TheTesla/ATXMega32a4u-USB-Breakout/README.md

ATXMega32a4u-USB-Breakout
=========================

Breakoutboard for ATXMega32a4u to ATXMega128a4u with micro-USB

Creator: http://entroserv.de

Support: support@entroserv.de (german and english)

# Quickstart

power up: connect 3.3 V to pin3 and GND to pin2 -> yellow led is illuminated

programming: connect atmel jtagice3 to the pdi header on top side of the board
