TheTesla/ATXMega32a4u-USB-Breakout/Hinweise/Hinweise.tex

%% Basierend auf einer TeXnicCenter-Vorlage von Mark Müller
%%%%%%%%%%%%%%%%%%%%%%%%%%%%%%%%%%%%%%%%%%%%%%%%%%%%%%%%%%%%%%%%%%%%%%%

% Wählen Sie die Optionen aus, indem Sie % vor der Option entfernen  
% Dokumentation des KOMA-Script-Packets: scrguide

%%%%%%%%%%%%%%%%%%%%%%%%%%%%%%%%%%%%%%%%%%%%%%%%%%%%%%%%%%%%%%%%%%%%%%%
%% Optionen zum Layout des Artikels                                  %%
%%%%%%%%%%%%%%%%%%%%%%%%%%%%%%%%%%%%%%%%%%%%%%%%%%%%%%%%%%%%%%%%%%%%%%%
\documentclass[%
a4paper
%a5paper,							% alle weiteren Papierformat einstellbar
%landscape,						% Querformat
%10pt,								% Schriftgröße (12pt, 11pt (Standard))
%BCOR1cm,							% Bindekorrektur, bspw. 1 cm
%DIVcalc,							% führt die Satzspiegelberechnung neu aus
%											  s. scrguide 2.4
%twoside,							% Doppelseiten
%twocolumn,						% zweispaltiger Satz
%halfparskip*,				% Absatzformatierung s. scrguide 3.1
%headsepline,					% Trennline zum Seitenkopf	
%footsepline,					% Trennline zum Seitenfuß
%titlepage,						% Titelei auf eigener Seite
%normalheadings,			% Überschriften etwas kleiner (smallheadings)
%idxtotoc,						% Index im Inhaltsverzeichnis
%liststotoc,					% Abb.- und Tab.verzeichnis im Inhalt
%bibtotoc,						% Literaturverzeichnis im Inhalt
%abstracton,					% Überschrift über der Zusammenfassung an	
%leqno,   						% Nummerierung von Gleichungen links
%fleqn,								% Ausgabe von Gleichungen linksbündig
%draft								% überlangen Zeilen in Ausgabe gekennzeichnet
]
{scrartcl}

%\pagestyle{empty}		% keine Kopf und Fußzeile (k. Seitenzahl)
%\pagestyle{headings}	% lebender Kolumnentitel  

%% Deutsche Anpassungen %%%%%%%%%%%%%%%%%%%%%%%%%%%%%%%%%%%%%
\usepackage[ngerman]{babel}
\usepackage[T1]{fontenc}
\usepackage[ansinew]{inputenc}

\usepackage{lmodern} %Type1-Schriftart für nicht-englische Texte
\usepackage{url}

%% Packages für Grafiken & Abbildungen %%%%%%%%%%%%%%%%%%%%%%
\usepackage{graphicx} %%Zum Laden von Grafiken
\usepackage{geometry} 

%\usepackage{subfig} %%Teilabbildungen in einer Abbildung
%\usepackage{pst-all} %%PSTricks - nicht verwendbar mit pdfLaTeX

\geometry{a4paper,left=23mm,right=25mm, top=25mm, bottom=25mm} 

%% Beachten Sie:
%% Die Einbindung einer Grafik erfolgt mit \includegraphics{Dateiname}
%% bzw. über den Dialog im Einfügen-Menü.
%% 
%% Im Modus "LaTeX => PDF" können Sie u.a. folgende Grafikformate verwenden:
%%   .jpg  .png  .pdf  .mps
%% 
%% In den Modi "LaTeX => DVI", "LaTeX => PS" und "LaTeX => PS => PDF"
%% können Sie u.a. folgende Grafikformate verwenden:
%%   .eps  .ps  .bmp  .pict  .pntg

%% Bibliographiestil %%%%%%%%%%%%%%%%%%%%%%%%%%%%%%%%%%%%%%%%%%%%%%%%%%
%\usepackage{natbib}

\newcommand{\product}{XMega128a4u USB BO}
\newcommand{\hspacesymb}{2.7cm}
\newcommand{\symbwith}{1.2cm}

\begin{document}

\pagestyle{empty} %%Keine Kopf-/Fusszeilen auf den ersten Seiten.
\pagenumbering{gobble}

%%%%%%%%%%%%%%%%%%%%%%%%%%%%%%%%%%%%%%%%%%%%%%%%%%%%%%%%%%%%%%%%%%%%%%%
%% Ihr Artikel                                                       %%
%%%%%%%%%%%%%%%%%%%%%%%%%%%%%%%%%%%%%%%%%%%%%%%%%%%%%%%%%%%%%%%%%%%%%%%

%% eigene Titelseitengestaltung %%%%%%%%%%%%%%%%%%%%%%%%%%%%%%%%%%%%%%%    
%\begin{titlepage}
%Einsetzen der TXC Vorlage "Deckblatt" möglich
%\end{titlepage}

%% Angaben zur Standardformatierung des Titels %%%%%%%%%%%%%%%%%%%%%%%%
%\titlehead{Titelkopf }
%\subject{Typisierung}

%\title{Hinweise}
%\author{Ihr Name}
%\and{Der Name des Co-Autoren}
%\thanks{Fußnote}			% entspr. \footnote im Fließtext
\date{}							% falls anderes, als das aktuelle gewünscht
%\publishers{Herausgeber}

%% Widmungsseite %%%%%%%%%%%%%%%%%%%%%%%%%%%%%%%%%%%%%%%%%%%%%%%%%%%%%%
%\dedication{Widmung}

%\maketitle 						% Titelei wird erzeugt

%% Zusammenfassung nach Titel, vor Inhaltsverzeichnis %%%%%%%%%%%%%%%%%
%\begin{abstract}
% Für eine kurze Zusammenfassung des folgenden Artikels.
% Für die Überschrift s. \documentclass[abstracton].
%\end{abstract}

%% Erzeugung von Verzeichnissen %%%%%%%%%%%%%%%%%%%%%%%%%%%%%%%%%%%%%%%
%\tableofcontents			% Inhaltsverzeichnis
%\listoftables				% Tabellenverzeichnis
%\listoffigures				% Abbildungsverzeichnis

%% Der Text %%%%%%%%%%%%%%%%%%%%%%%%%%%%%%%%%%%%%%%%%%%%%%%%%%%%%%%%%%%

\begin{Huge}
	\begin{center}
		\textbf{Hinweise}
	\end{center}
\end{Huge}

\section*{Produktdaten}
Bezeichnung: \product\\
Produktion: Seeed Technology Inc.\\
Test: Seeed Technology Inc.\\
produziert am: 20.02.2014\\
importiert am: 03.03.2014

\section*{Hersteller/Importeur}

Stefan Helmert\\
Brückenstr. 2\\
09111 Chemnitz\\
USt-IdNr.: DE294678351

\section*{Produktdetails}

\url{https://github.com/TheTesla/ATXMega32a4u-USB-Breakout/tree/Xmega128a4u}

\section*{Gewährleistung}

Alle Produkte wurden auf einwandfreie Funktion getestet. Gewährleistungsansprüche können nur bei eindeutigen Produktions- und Transportschäden geltend gemacht werden. 

Für Schäden, die auch durch falsche Handhabung auftreten können (z.~B. Überspannung), wird nicht gehaftet. 

\section*{Haftung}

Das Produkt ist nicht für den Einsatz in Systemen vorgesehen, in denen eine Fehlfunktion zu erheblichen Schäden führen kann. Es erfolgt keine Haftung für Schäden und Folgeschäden, die durch unsachgemäße Verwendung oder unzureichende Funktion des Produktes verursacht wurden. 

\section*{Produktart}

\texttt{\product} ist kein Elektrogerät im Sinne es ElektroG, da es keine eigenständige Funktion besitzt. Die Funktion wird im Wesentlichen durch die Außenbeschaltung und verwendeter Firmware bestimmt.  

Da dieses Produkt kein Elektrogerät, sondern eine Elektronikkomponente ist, entfallen die CE-Kennzeichnung und Konformitätserklärung. Die Kennzeichnungspflicht eines Endproduktes, welches diese Komponente enthält, bleibt davon unberührt. Ob und welche Kennzeichnungspflichten oder Nachweispflichten bestehen, hängt von Bauart und Einsatzzweck des daraus erzeugten Endproduktes ab. 

\vspace{0.5cm}

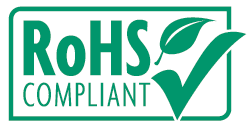
[picture p1: Hinweise/RoHSCompliant.png]
 \hspace{\hspacesymb}
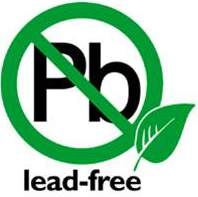
[picture p2: Hinweise/PBfree.png]
 \hspace{\hspacesymb}
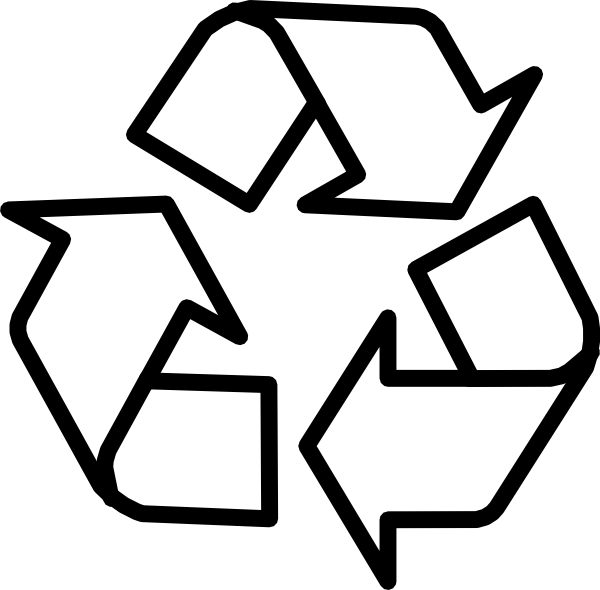
[picture p3: Hinweise/recycling.png]
 \hspace{\hspacesymb}
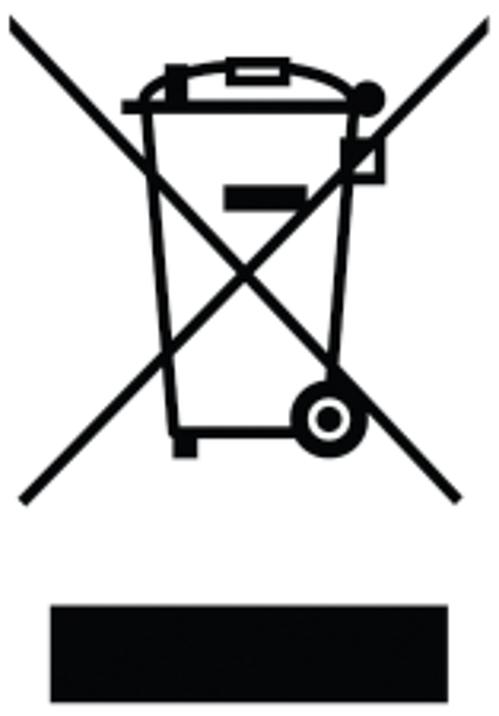
[picture p4: Hinweise/muelltonne.png]


%% Bibliographie unter Verwendung von dinnat %%%%%%%%%%%%%%%%%%%%%%%%%%
%\setbibpreamble{Präambel}		% Text vor dem Verzeichnis
%\bibliographystyle{dinat}
%\bibliography{bibliographie}	% Sie benötigen einen *.bib-Datei

\end{document}
