TheTesla/ATXMega32a4u-USB-Breakout/Hinweise/CE.png

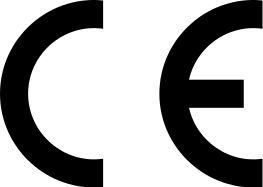
Hinweise/CE.png
