TheTesla/ATXMega32a4u-USB-Breakout/Xmega128a4uBO.jpg

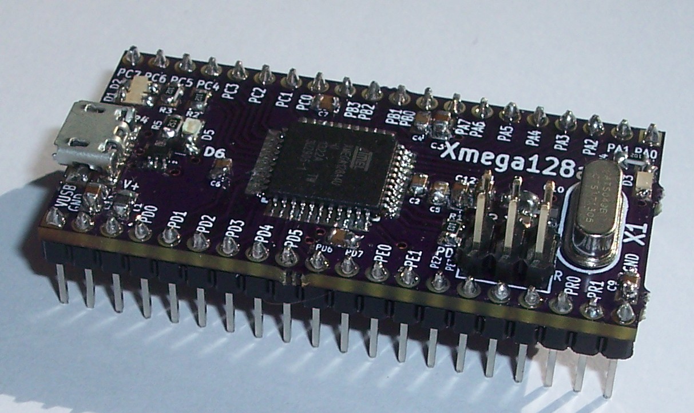
Xmega128a4uBO.jpg
