TheTesla/ATXMega32a4u-USB-Breakout/Xmega128a4uBOb.png

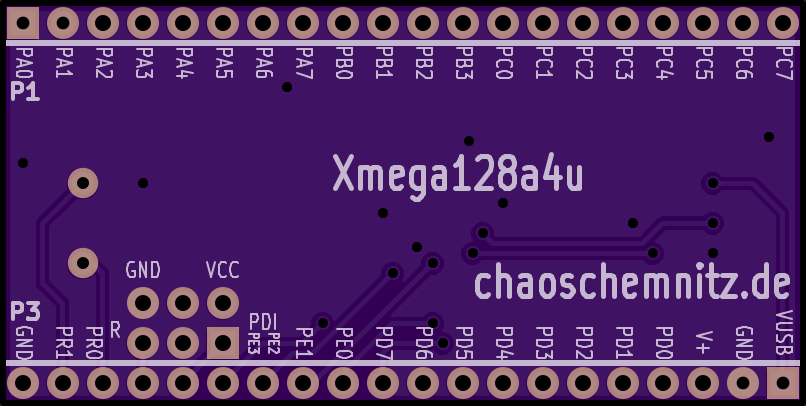
Xmega128a4uBOb.png
