TheTesla/ATXMega32a4u-USB-Breakout/Xmega128a4uBOf.png

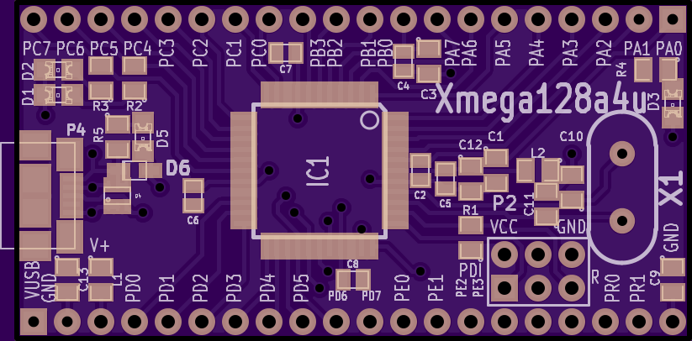
Xmega128a4uBOf.png
