TheTesla/ATXMega32a4u-USB-Breakout/Xmega128a4uBOtestb.png

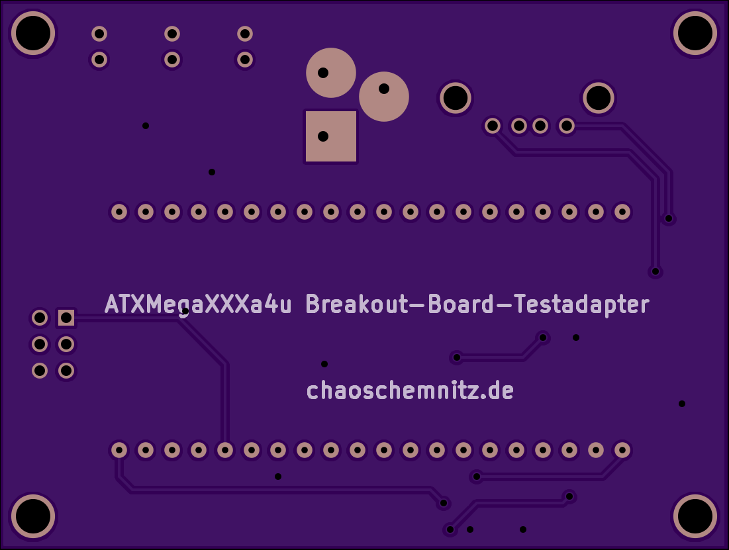
Xmega128a4uBOtestb.png
