TheTesla/ATXMega32a4u-USB-Breakout/Xmega128a4uBOtestf.png

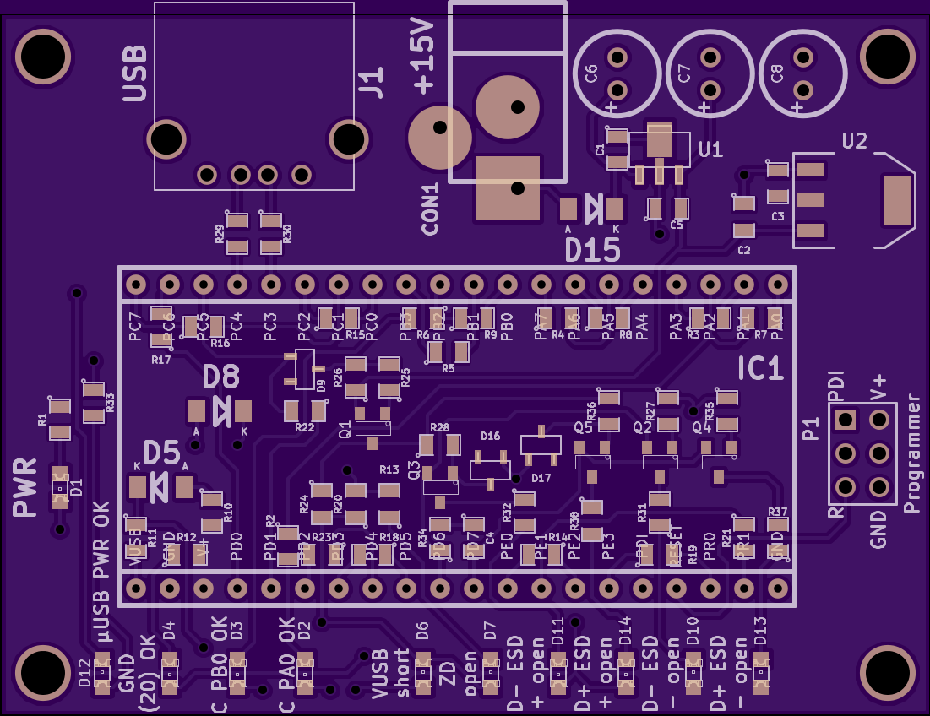
Xmega128a4uBOtestf.png
