TheTesla/ATXMega32a4u-USB-Breakout/ATXMega128_USBSchaltplan.pdf

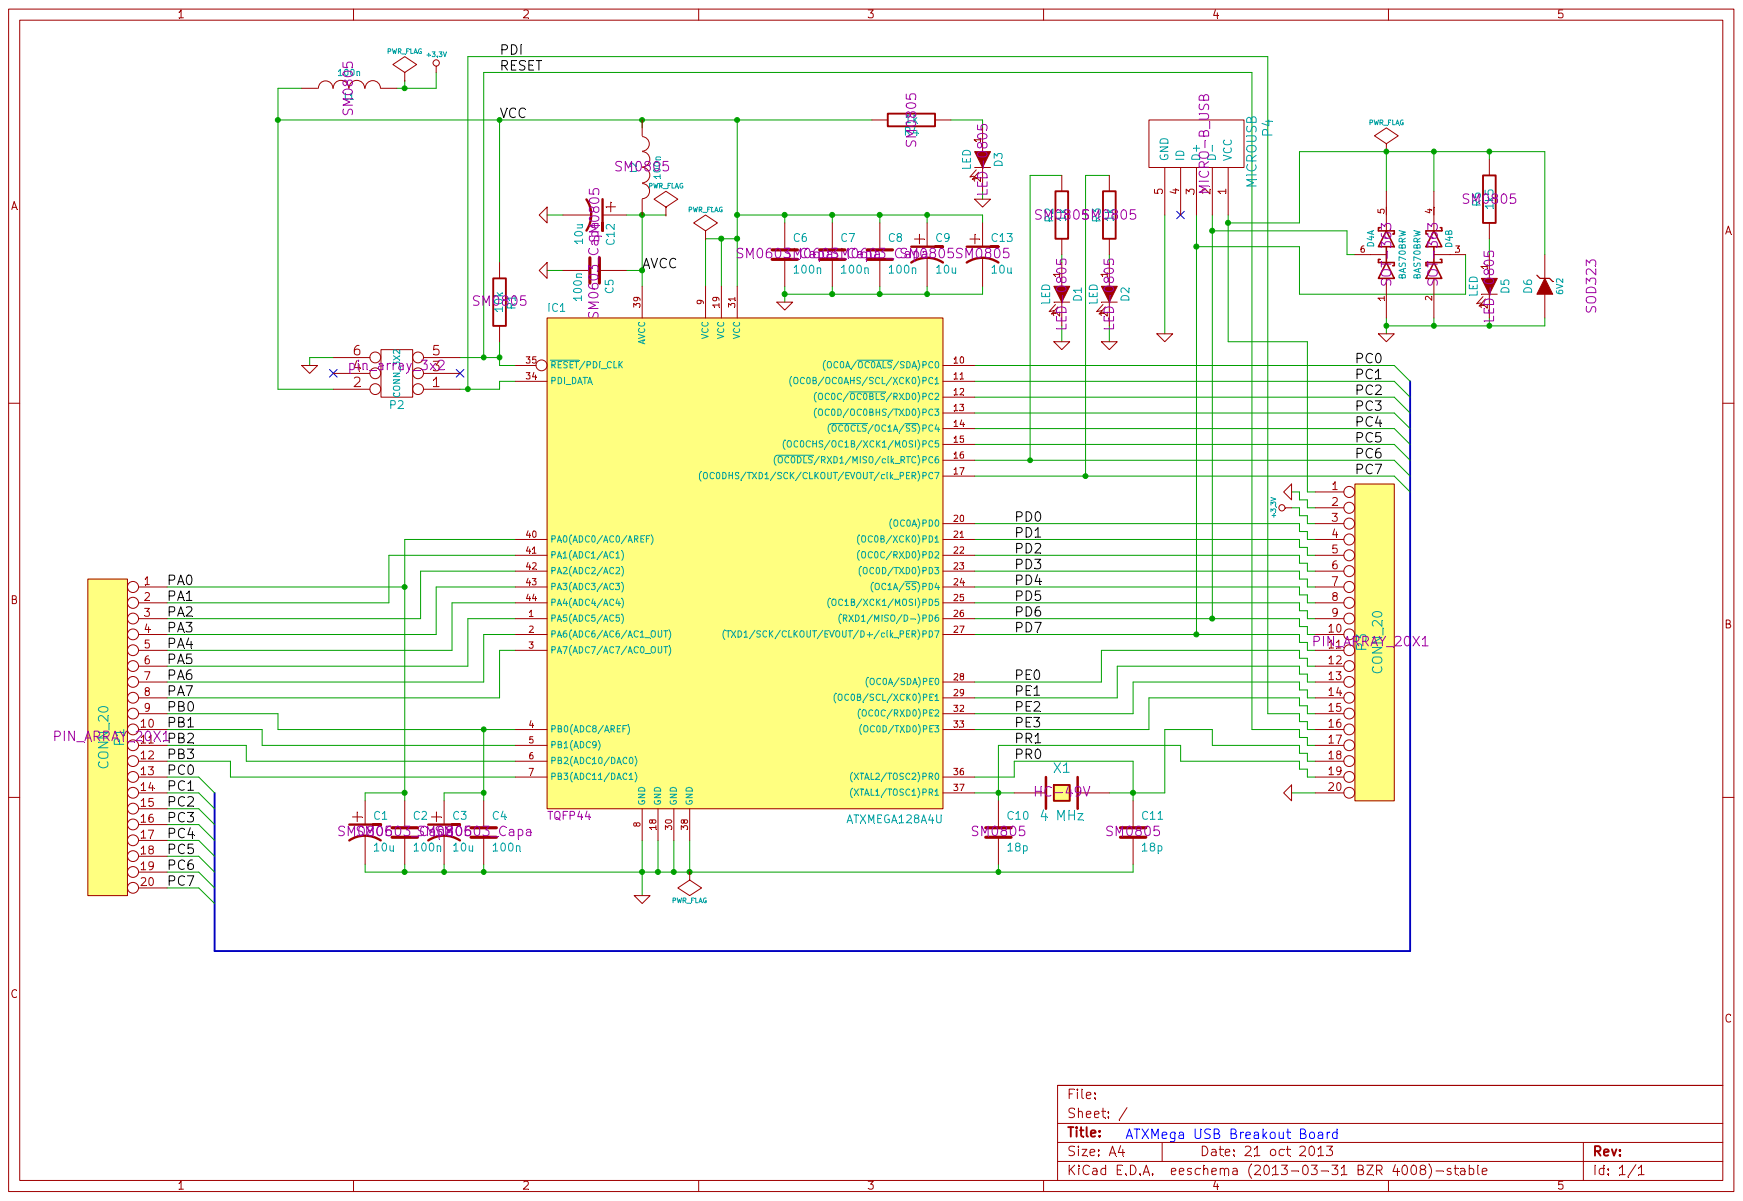
[picture p13: page 1]
