TheTesla/ATXMega32a4u-USB-Breakout/ATXMega128_USB.sch

## KiCad design ATXMega128_USB.sch (2014-01-26)

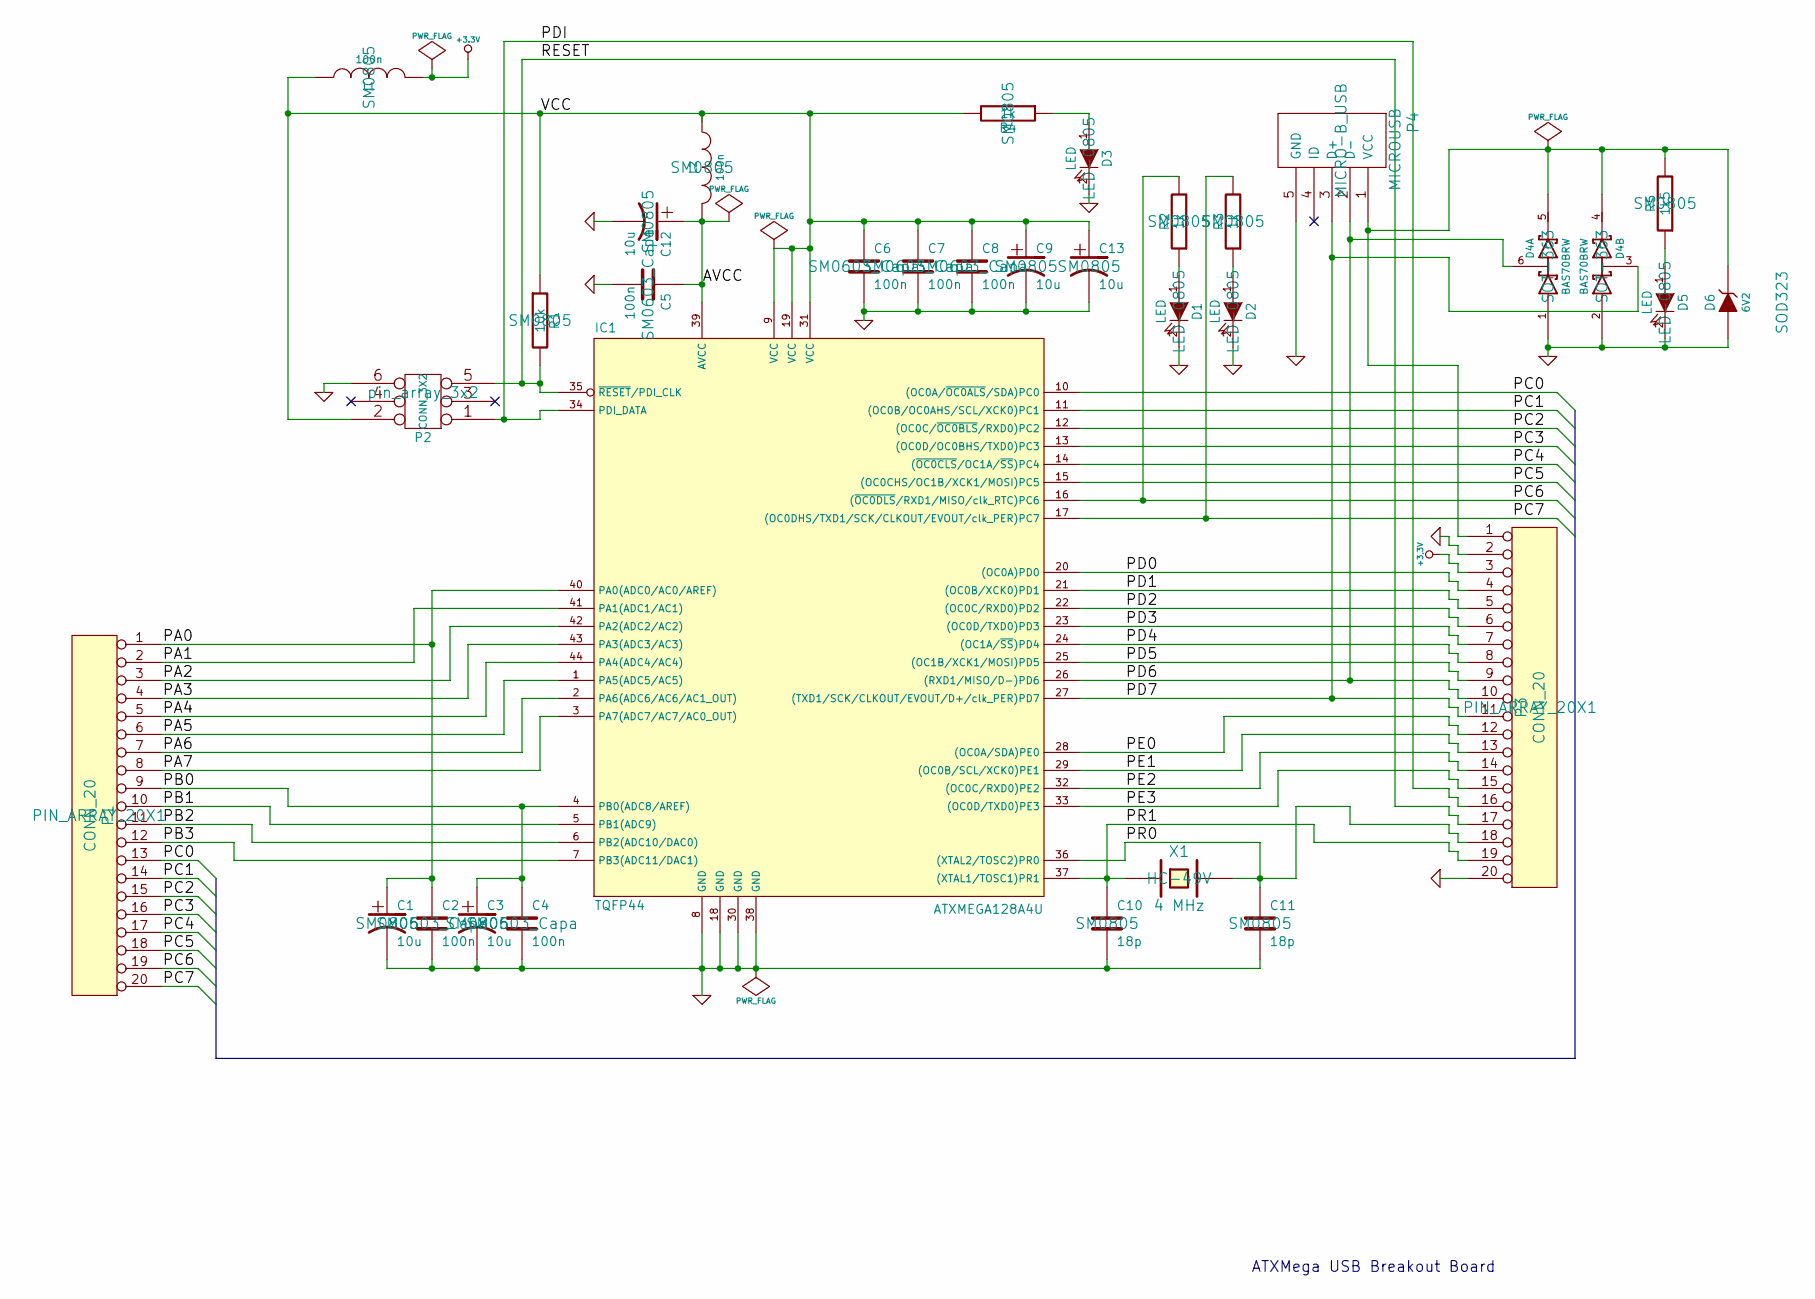
[picture p15: schematic ATXMega128_USB.sch]

Parts:
C1, C3, C9, C12, C13: 10u; SM0805; Manufacturer Part Number CC0805ZKY5V6BB106; Digi-Key Part Number 311-1355-1-ND
C2, C4, C5, C6, C7, C8: 100n; SM0603_Capa; Manufacturer Part Number CL10F104ZA8NNNC; Digi-Key Part Number 1276-1011-1-ND
C10, C11: 18p; SM0805; Manufacturer Part Number CL21C180JBANNNC; Digi-Key Part Number 1276-1107-1-ND
D1: LED; LED-0805; Manufacturer Part Number LG R971-KN-1; Digi-Key Part Number 475-1410-1-ND
D2: LED; LED-0805; Manufacturer Part Number LS R976-NR-1; Digi-Key Part Number 475-1278-1-ND
D3: LED; LED-0805; Manufacturer Part Number LY R976-PS-36; Digi-Key Part Number 475-2560-1-ND
D4: BAS70BRW; SOT-363; Digi-Key Part Number BAS70BRW-TPCT-ND
D5: LED; LED-0805; Manufacturer Part Number LTST-C170TBKT; Digi-Key Part Number 160-1579-1-ND
D6: 6V2; SOD323; Manufacturer Part Number MM3Z6V2ST1G; Digi-Key Part Number MM3Z6V2ST1GOSCT-ND
IC1: ATXMEGA128A4U; TQFP44; Manufacturer Part Number ATXMEGA128A4U-AU; Digi-Key Part Number ATXMEGA128A4U-AU-ND
L1, L2: 100n; SM0805; Manufacturer Part Number AIML-0805-R10K-T; Digi-Key Part Number 535-11645-1-ND
P1, P3: CONN_20; PIN_ARRAY_20X1
P2: CONN_3X2; pin_array_3x2
P4: MICROUSB; MICRO-B_USB; Manufacturer Part Number 10118192-0001LF; Digi-Key Part Number 609-4613-2-ND
R1: 10k; SM0805; Digi-Key Part Number RMCF0805JG10K0-ND
R2, R3, R4: 1k; SM0805; Manufacturer Part Number RMCF0805JT1K00; Digi-Key Part Number RMCF0805JT1K00CT-ND
R5: 1k5; SM0805; Manufacturer Part Number RMCF0805JT1K50; Digi-Key Part Number RMCF0805JT1K50CT-ND
X1: 4 MHz; HC-49V; Manufacturer Part Number ATS040B; Digi-Key Part Number CTX896-ND

Connections:
+3,3V: P3.3
+3.3V: L1.2
AVCC: C5.2, C12.1, IC1.39 (AVCC), L2.2
GND: C1.2, C2.2, C3.2, C4.2, C5.1, C6.2, C7.2, C8.2, C9.2, C10.2, C11.2, C12.2, C13.2, D1.2 (K), D2.2 (K), D3.2 (K), D4.1 (anode), D4.2 (Anode), D5.2 (K), D6.1 (A), IC1.8 (GND), IC1.18 (GND), IC1.30 (GND), IC1.38 (GND), P2.6, P3.2, P3.20, P4.5 (GND)
unnamed: D1.1 (A), R2.1
unnamed: D2.1 (A), R3.1
unnamed: D3.1 (A), R4.1
unnamed: D4.4 (cathode), D4.5 (cathode), D6.2 (K), P3.1, P4.1 (VCC), R5.2
unnamed: D5.1 (A), R5.1
PA0: C1.1, C2.1, IC1.40 (PA0(ADC0/AC0/AREF)), P1.1
PA1: IC1.41 (PA1(ADC1/AC1)), P1.2
PA2: IC1.42 (PA2(ADC2/AC2)), P1.3
PA3: IC1.43 (PA3(ADC3/AC3)), P1.4
PA4: IC1.44 (PA4(ADC4/AC4)), P1.5
PA5: IC1.1 (PA5(ADC5/AC5)), P1.6
PA6: IC1.2 (PA6(ADC6/AC6/AC1_OUT)), P1.7
PA7: IC1.3 (PA7(ADC7/AC7/AC0_OUT)), P1.8
PB0: C3.1, C4.1, IC1.4 (PB0(ADC8/AREF)), P1.9
PB1: IC1.5 (PB1(ADC9)), P1.10
PB2: IC1.6 (PB2(ADC10/DAC0)), P1.11
PB3: IC1.7 (PB3(ADC11/DAC1)), P1.12
PC0: IC1.10 ((OC0A/~OC0ALS~/SDA)PC0), P1.13
PC1: IC1.11 ((OC0B/OC0AHS/SCL/XCK0)PC1), P1.14
PC2: IC1.12 ((OC0C/~OC0BLS~/RXD0)PC2), P1.15
PC3: IC1.13 ((OC0D/OC0BHS/TXD0)PC3), P1.16
PC4: IC1.14 ((~OC0CLS~/OC1A/~SS~)PC4), P1.17
PC5: IC1.15 ((OC0CHS/OC1B/XCK1/MOSI)PC5), P1.18
PC6: IC1.16 ((~OC0DLS~/RXD1/MISO/clk_RTC)PC6), P1.19, R2.2
PC7: IC1.17 ((OC0DHS/TXD1/SCK/CLKOUT/EVOUT/clk_PER)P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), P1.20, R3.2
PD0: IC1.20 ((OC0A)PD0), P3.4
PD1: IC1.21 ((OC0B/XCK0)PD1), P3.5
PD2: IC1.22 ((OC0C/RXD0)PD2), P3.6
PD3: IC1.23 ((OC0D/TXD0)PD3), P3.7
PD4: IC1.24 ((OC1A/~SS~)PD4), P3.8
PD5: IC1.25 ((OC1B/XCK1/MOSI)PD5), P3.9
PD6: D4.6 (AK), IC1.26 ((RXD1/MISO/D-)PD6), P3.10, P4.2 (D-)
PD7: D4.3 (AK), IC1.27 ((TXD1/SCK/CLKOUT/EVOUT/D+/clk_PER)PD7), P3.11, P4.3 (D+)
PDI: IC1.34 (PDI_DATA), P2.1, P3.16
PE0: IC1.28 ((OC0A/SDA)PE0), P3.12
PE1: IC1.29 ((OC0B/SCL/XCK0)PE1), P3.13
PE2: IC1.32 ((OC0C/RXD0)PE2), P3.14
PE3: IC1.33 ((OC0D/TXD0)PE3), P3.15
PR0: C11.1, IC1.36 ((XTAL2/TOSC2)PR0), P3.18, X1.2
PR1: C10.1, IC1.37 ((XTAL1/TOSC1)PR1), P3.19, X1.1
RESET: IC1.35 (~RESET~/PDI_CLK), P2.5, P3.17, R1.2
VCC: C6.1, C7.1, C8.1, C9.1, C13.1, IC1.9 (VCC), IC1.19 (VCC), IC1.31 (VCC), L1.1, L2.1, P2.2, R1.1, R4.2

Notes on the sheet:
ATXMega USB Breakout Board
