TheTesla/ATXMega32a4u-USB-Breakout/ATXMega128_USB_TEST_Board/ATXMega128_USB_TEST_Board.sch

## KiCad design ATXMega128_USB_TEST_Board/ATXMega128_USB_TEST_Board.sch (2013-10-11)

Schematic: ATXMega128_USB_TEST_Board.sch

Parts:
C1, C2: 330n
C3, C4, C5: 100n
C6: 100u
C7, C8: 10u
CON1: BARREL_JACK
D1, D2, D3, D4, D6, D7, D10, D11, D12, D13, D14: LED
D5, D15: 1N4148
D8: 5V6
D9: 9V6
D16, D17: 4V7
IC1: ATXMEGA128A4U_BOARD; ATXMega128a4u_Breakout
J1: USBJACK
P1: CONN_3X2
Q1, Q3, Q5: BC807-40; SOT-23
Q2, Q4: BC817-40; SOT-23
R1, R2, R6, R10, R12, R13, R25, R26, R27, R28, R31, R32, R34, R35, R36, R37, R38: 820
R3, R4, R5, R8, R14, R15, R16, R17, R18, R20, R22, R23, R29, R30: 10k
R7, R9, R19, R21: 200k
R11, R33: 4k7
R24: 470
U1: MC78L12ACH; SOT-89
U2: NCP1117ST33T3G
