TheTesla/ATXMega32a4u-USB-Breakout/(commit log)

2013-04-05 Grundversion USB-Buchse: mouser micro-USB USB-ESD-Schutz: Standard BAS70 einzelne Dioden ATXMega: TQFP-44
    [ATXMega32_USB.brd, ATXMega32_USB.csv, ATXMega32_USB.sch]
2013-04-06 USB-ESD protection: BAS70BRW Schematic bearbeitet
2013-04-06 Board mit BAS70BRW (schlechtes Layout)
    [ATXMega32_USB.brd, ATXMega32_USB.sch]
2013-04-06 Layout mit BAS70BRW besser, USB-LED verschoben
    [ATXMega32_USB.brd]
2013-04-06 Update der Bestellnummern, Bauteilwerte
    [ATXMega32_USB.csv, ATXMega32_USB.sch]
2013-04-07 Z-Diode (USB ESD)
    [ATXMega32_USB.brd, ATXMega32_USB.csv, ATXMega32_USB.sch]
2013-04-07 Update BOM, Rename-Script
    [ATXMega32_USB.csv, ATXMega32_USB.sch]
2013-04-07 Kupfer-Abstand auf 0,2 mm erhöht
    [ATXMega32_USB.brd]
2013-04-07 LED-Gehäuse geändert (0805 -> LED-0805) Rename-Script Board-Outline umbenannt (GBR->GKO)
    [ATXMega32_USB.brd]
2013-04-15 Seeed OPL SKU ergänzt; csv mit neuem eigenem xsl-Plugin
    [ATXMega32_USB.csv, ATXMega32_USB.sch]
2013-04-19 removed space from one Digi-Key Part Number
    [ATXMega32_USB.sch]
2013-05-14 updated parts - BOM
    [ATXMega32_USB.brd, ATXMega32_USB.sch]
2013-05-19 components changed: cheaper leds, minimum quantity 1, no obsolete parts
    [ATXMega32_USB.sch]
2013-08-17 footprint BAS70 SOT-363 changed (larger pads), footprint micro-USB changed
    [ATXMega32_USB.brd, ATXMega32_USB.sch]
2013-08-29 PIN names added
    [ATXMega32_USB.brd]
2013-08-29 Xmega128a4u text added
    [ATXMega32_USB.brd]
2013-08-31 new branch: atxmega128a4u, version with text on PCB
    [ATXMega128_USB.brd]
2013-09-01 lib-cache-file added
    [ATXMega128_USB.sch]
2013-09-01 board and schematic updated to atxmega128a4u
    [ATXMega128_USB.brd, ATXMega128_USB.sch]
2013-09-08 Test-Board-Design started
    [ATXMega128_USB_TEST_Board.sch]
2013-09-09 Test-Board schematic nearly ready
    [ATXMega128_USB.sch, ATXMega128_USB_TEST_Board.sch]
2013-09-10 ATXMega_Breaout-Footprint designed, Testboard PCB started
    [ATXMega128_USB_TEST_Board.kicad_pcb, ATXMega128_USB_TEST_Board.sch]
2013-09-13 Testboard PCB designed
    [ATXMega128_USB.GBL, ATXMega128_USB.GBO, ATXMega128_USB.GBS, ATXMega128_USB.GKO, ATXMega128_USB.GTL, ATXMega128_USB.GTO, ATXMega128_USB.GTS, ATXMega128_USB.XLN]
2013-09-13 Power Supply Diode added, Board Edge Cuts added
    [ATXMega128_USB_TEST_Board.GBL, ATXMega128_USB_TEST_Board.GBO, ATXMega128_USB_TEST_Board.GBS, ATXMega128_USB_TEST_Board.GKO, ATXMega128_USB_TEST_Board.GTL, ATXMega128_USB_TEST_Board.GTO, ATXMega128_USB_TEST_Board.GTS, ATXMega128_USB_TEST_Board.XLN]
2013-09-15 Testboard complete
    [ATXMega128_USB_TEST_Board.GBL, ATXMega128_USB_TEST_Board.GBO, ATXMega128_USB_TEST_Board.GBS, ATXMega128_USB_TEST_Board.GKO, ATXMega128_USB_TEST_Board.GTL, ATXMega128_USB_TEST_Board.GTO, ATXMega128_USB_TEST_Board.GTS, ATXMega128_USB_TEST_Board.XLN]
2013-10-11 Testboard updated, Testsoftware ready
    [ATXMega128_USB.sch, ATXMega128_USB_TEST_Board.sch]
2013-10-12 BOM csv with tabulators instead of commas, xlsx-file
    [ATXMega128_USB.csv, ATXMega128_USB.xlsx, ATXMega128_USB_TEST_Board.csv]
2014-01-26 better package for D4, D4 shifted down
    [ATXMega128_USB-LJF1014.xlsx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]
2014-07-25 Changed notes.: it is nota an electrical appliance, it is an electronic device (ElektroG)
2014-08-14 silkscreen changes: LEDs "RX" and "TX", text "entroserv.de"
    [ATXMega128_USB.GBL, ATXMega128_USB.GBO, ATXMega128_USB.GBS, ATXMega128_USB.GKO, ATXMega128_USB.GTL, ATXMega128_USB.GTO, ATXMega128_USB.GTS, ATXMega128_USB.XLN]
2014-08-21 some changes on silk screen/text
    [ATXMega128_USB.GBL, ATXMega128_USB.GBO, ATXMega128_USB.GBS, ATXMega128_USB.GKO, ATXMega128_USB.GTL, ATXMega128_USB.GTO, ATXMega128_USB.GTS, ATXMega128_USB.XLN]
